cgreenbaum/Sensor-Breakout-Board/README.md

# Sensor-Breakout-Board
Sensor breakout board for routing sensor signals and CAN bussing in the Oil Pan enclosure of RW-3x.
