cgreenbaum/Sensor-Breakout-Board/AssemblyBoM.xlsx

Sensor Breakout Board V1.0
Qty | Description | Category | Manufacturer | Mfg part | Vendor | Vendor part | Unit cost | Designator
1 | CONNECTOR, RECEPTACLE HOUSING, 2 POSITION, 3MM (http://www.newark.com/molex/43025-0200/connector-receptacle-housing-2/dp/56H9399) | Connector | MOLEX | 43025-0200 | Newark | 56H9399 | $0.41 | Mating Connector for X16
5 | CONNECTOR, RECEPTACLE HOUSING, 6 POSITION, 3MM (http://www.newark.com/molex/43025-0600/connector-receptacle-housing-6/dp/01E8841) | Connector | MOLEX | 43025-0600 | Newark | 01E8841 | $0.46 | Mating Connector for X17, X18, X19, X20, X21
32 | Contact, Micro-Fit 3.0™, 43030 Series, Socket, 24 AWG, 20 AWG, Crimp, Phosphor Bronze (http://www.newark.com/molex/43030-0008/contact-socket-24-20awg-crimp/dp/56H9413) | Contacts | MOLEX | 43030-0008 | Newark | 56H9413 | $0.22
 | Subtotal |  |  |  |  |  | $9.75
