cgreenbaum/Sensor-Breakout-Board/BoM.xlsx

Sensor Breakout Board V1.0
Qty | Description | Category | Manufacturer | Mfg part | Vendor | Vendor part | Unit cost | Designator
35 | Non Populated Resistors
14 | Surface Mount Chip Resistor, Thick Film, AEC-Q200 ERJ Series, 0 ohm, 100 mW, 75 V, 0603 [1608 Metric] (http://www.newark.com/panasonic-electronic-components/erj-3gey0r00v/res-thick-film-0r-0-1w-0603/dp/65T8702) | Common passives | PANASONIC ELECTRONIC COMPONENTS (http://www.newark.com/panasonic-electronic-components) | ERJ-3GEY0R00V | Newark | 65T8702 | $0.10 | R1, R9, R12, R13, R2, R4, R6, R25, R27, R45, R47, R49, R61, R73
5 | Surface Mount Chip Resistor, Thick Film, AEC-Q200 CRCW Series, 10 kohm, 100 mW, ± 5%, 75 V (http://www.newark.com/vishay-dale/crcw060310k0jnea/res-thick-film-10k-5-0-1w-0603/dp/52K8066) | Common passives | VISHAY (http://www.newark.com/vishay) | CRCW060310K0JNEA | Newark | 52K8066 | $0.03 | R15, R28, R31, R35, R74
4 | Surface Mount Chip Resistor, Thick Film, RC Series, 1 kohm, 100 mW, ± 5%, 50 V, 0603 [1608 Metric] (http://www.newark.com/yageo/rc0603jr-131kl/res-thick-film-1k-5-0-1w-0603/dp/68R0220) | Common passives | YAGEO (http://www.newark.com/yageo) | RC0603JR-131KL | Newark | 68R0220 | $0.002 | R3, R5, R24, R26
4 | Surface Mount Chip Resistor, Thick Film, RC Series, 12 kohm, 100 mW, ± 5%, 50 V, 0603 [1608 Metric] (http://www.newark.com/yageo/rc0603jr-0712kl/res-thick-film-12k-5-0-1w-0603/dp/68R0149) | Common passives | YAGEO (http://www.newark.com/yageo) | RC0603JR-0712KL | Newark | 68R0149 | $0.001 | R16, R18, R41, R43
4 | Surface Mount Chip Resistor, Thick Film, AEC-Q200 CRCW Series, 20 kohm, 100 mW, ± 1%, 75 V (http://www.newark.com/vishay-dale/crcw060320k0fkeb/res-thick-film-20k-1-0-1w-0603/dp/43C4227) | Common passives | VISHAY (http://www.newark.com/vishay-dale/crcw060320k0fkeb/res-thick-film-20k-1-0-1w-0603/dp/43C4227) | CRCW060320K0FKEB (http://www.newark.com/vishay-dale/crcw060320k0fkeb/res-thick-film-20k-1-0-1w-0603/dp/43C4227) | Newark | 43C4227 (http://www.newark.com/vishay-dale/crcw060320k0fkeb/res-thick-film-20k-1-0-1w-0603/dp/43C4227) | $0.004 | R17, R19, R42, R44
12 | Non Populated Capacitors
16 | SMD Multilayer Ceramic Capacitor, MC Series, 270 pF, ± 10%, X7R, 50 V, 0603 [1608 Metric] (http://www.newark.com/multicomp/mc0603b271k500ct/ceramic-capacitor-270pf-50v-x7r/dp/06R4977) | Common passives | MULTICOMP (http://www.newark.com/multicomp/mc0603b271k500ct/ceramic-capacitor-270pf-50v-x7r/dp/06R4977) | MC0603B271K500CT (http://www.newark.com/multicomp/mc0603b271k500ct/ceramic-capacitor-270pf-50v-x7r/dp/06R4977) | Newark | 06R4977 (http://www.newark.com/multicomp/mc0603b271k500ct/ceramic-capacitor-270pf-50v-x7r/dp/06R4977) | $0.002 | C1, C2, C3, C5, C6, C17, C18, C21, C22, C23, C24, C25, C31, C32, C37
6 | SMD Multilayer Ceramic Capacitor, MC Series, 2.2 µF, +80%, -20%, Y5V, 10 V, 0603 [1608 Metric] (http://www.newark.com/multicomp/mc0603f225z100ct/ceramic-capacitor-2-2uf-10v-y5v/dp/06R5087) | Common passives | MULTICOMP (http://www.newark.com/multicomp/mc0603f225z100ct/ceramic-capacitor-2-2uf-10v-y5v/dp/06R5087) | MC0603F225Z100CT (http://www.newark.com/multicomp/mc0603f225z100ct/ceramic-capacitor-2-2uf-10v-y5v/dp/06R5087) | Newark | 06R5087 (http://www.newark.com/multicomp/mc0603f225z100ct/ceramic-capacitor-2-2uf-10v-y5v/dp/06R5087) | $0.01 | C4, C9, C10, C11, C12, C15
10 | Board-To-Board Connector, M22 Series, Through Hole, Receptacle, 10, 2 mm, Gold Plated Contacts (http://www.newark.com/harwin/m22-7131042/board-board-connector-receptacle/dp/71K8284?ost=M22-7131042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) | Connector | HARWIN | M22-7131042 | Newark | 71K8284 | $1.35 | X2, X3, X5, X6, X8, X9, X11, X12, X14, X15
5 | Board-To-Board Connector, M22 Series, Through Hole, Receptacle, 6, 2 mm, Gold Plated Contacts (http://www.newark.com/harwin/m22-7140342/board-board-connector-receptacle/dp/71K8300?ost=M22-7140342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) | Connector | HARWIN | M22-7140342 | Newark | 71K8300 | $0.73 | X1, X4, X7, X10, X13
1 | Contact, Micro-Fit 3.0™, 43045 Series, Through Hole, Brass (http://www.newark.com/molex/43045-0200/plug-socket-connector-header-2/dp/38C9818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) | Connector | MOLEX | 43045-0200 | Newark | 38C9818 | $0.81 | X16
5 | Header Connector,PCB Mount,RECEPT,6 Contacts,PIN,0.118 Pitch,R ANGLE PC TAIL Terminal,POLARIZED LCK (http://www.newark.com/molex/43045-0601/header-connector-pcb-mount-recept/dp/92M1173?ost=43045-0601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) | Connector | MOLEX | 43045-0601 | Newark | 92M1173 | $1.83 | X17, X18, X19, X20, X21
1 | Board-To-Board Connector, M22 Series, Through Hole, Header, 6, 2 mm, Gold Plated Contacts (http://www.newark.com/harwin/m22-2520305/board-board-connector-header-6/dp/89H8939?ost=M22-2520305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) | Connector | HARWIN | M22-2520305 | Newark | 89H8939 | $0.43 | X22
2 | Jumper (Busbar), Shunt, Shunt, Pin Headers, 2, 2 mm (http://www.newark.com/harwin/m22-1920046/jumper-socket-2way-2mm/dp/03M3588) | Jumper | HARWIN | M22-1920046 | Newark | 03M3588 | $0.15 | Mates with X22
 | Subtotal |  |  |  |  |  | $29.53
