cgreenbaum/Sensor-Breakout-Board/Modular-Sensor-Breakout-Board schematic.pdf

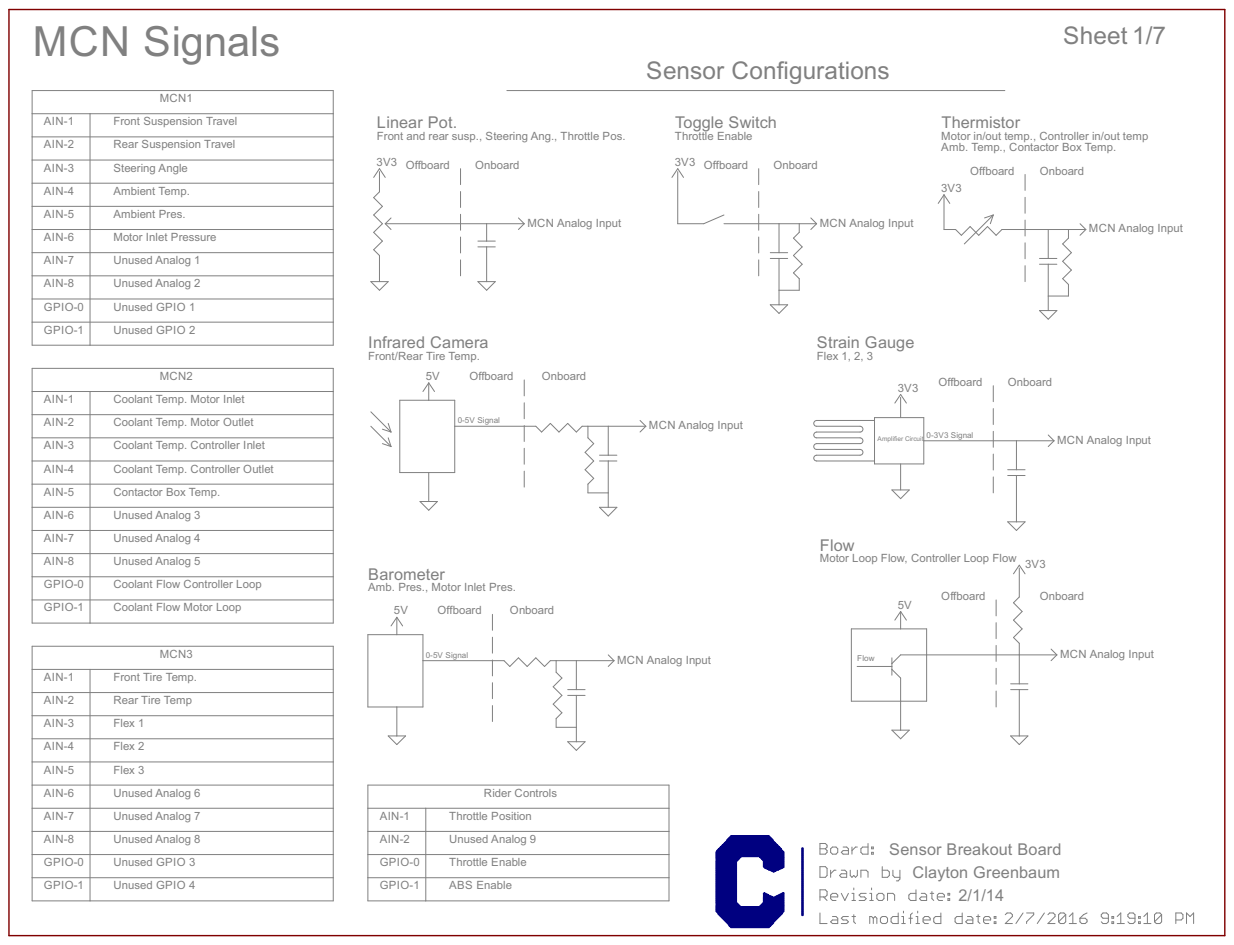
[picture p1: page 1]

AIN-1 | Front Suspension Travel

Thermistor
Motor in/out temp., Controller in/out temp
Amb. Temp., Contactor Box Temp.

AIN-2 | Rear Suspension Travel

AIN-4 | Steering Angle Ambient Temp. Ambient Pres. Motor Inlet Pressure Unused Analog 1
AIN-3

AIN-5

AIN-6

AIN-7

AIN-8 | Unused Analog 2

GPIO-0 | Unused GPIO 1

GPIO-1 | Unused GPIO 2

MCN Analog Input Amplifier Circuit 3V3

AIN-1 | Coolant Temp. Motor Inlet

AIN-2 | Coolant Temp. Motor Outlet

AIN-3 | Coolant Temp. Controller Inlet

AIN-4 | Coolant Temp. Controller Outlet

AIN-5 | Contactor Box Temp. Unused Analog 3

AIN-7 | Unused Analog 4

AIN-8 | Unused Analog 5

GPIO-0 | Coolant Flow Controller Loop

GPIO-1 | Coolant Flow Motor Loop

AIN-1 | Front Tire Temp. AIN-2

Rear Tire Temp

AIN-3 | Flex 1

AIN-4 | Flex 2

AIN-5 | Flex 3

AIN-6 | Unused Analog 6

AIN-7 | Unused Analog 7

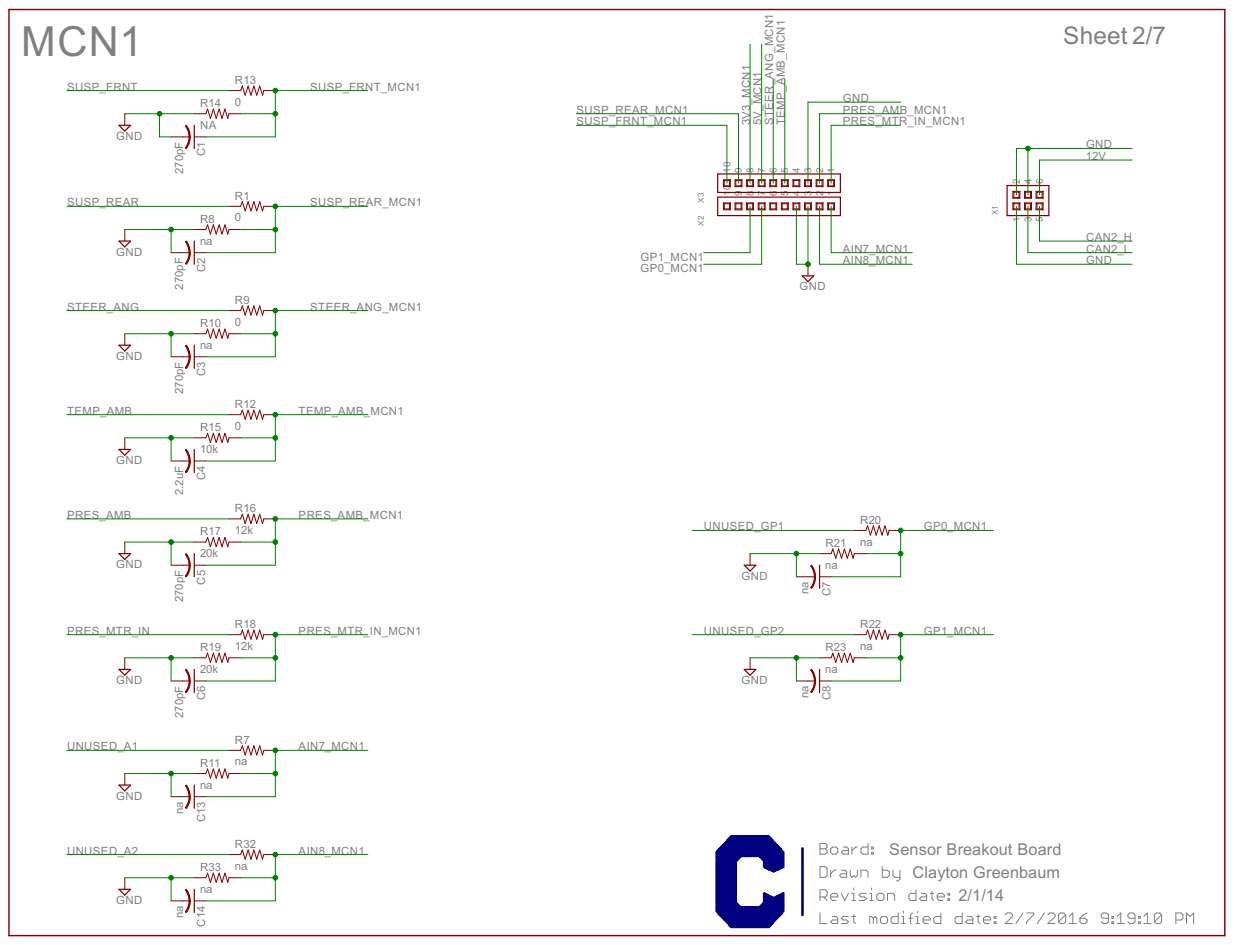
[picture p2: page 2]

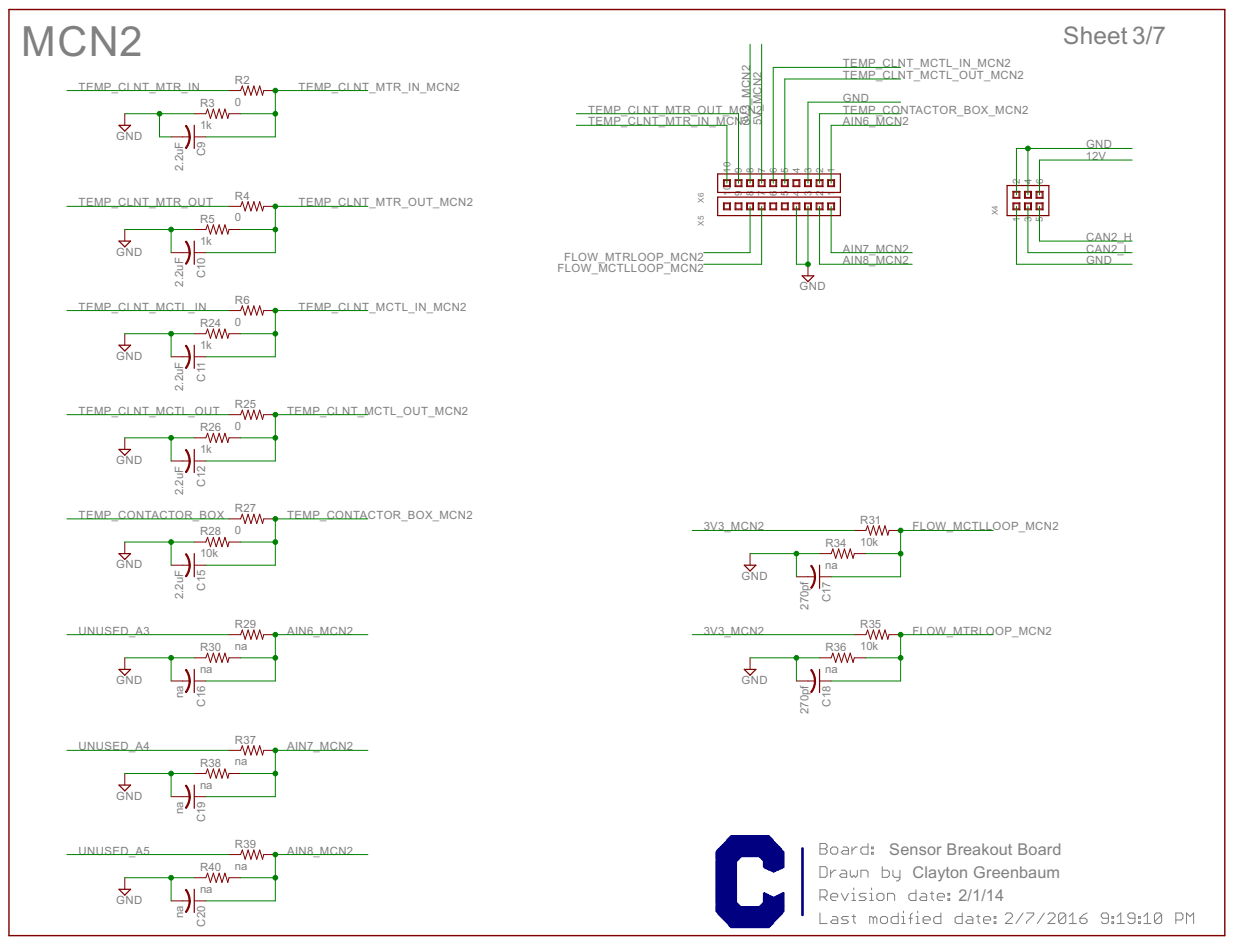
[picture p3: page 3]

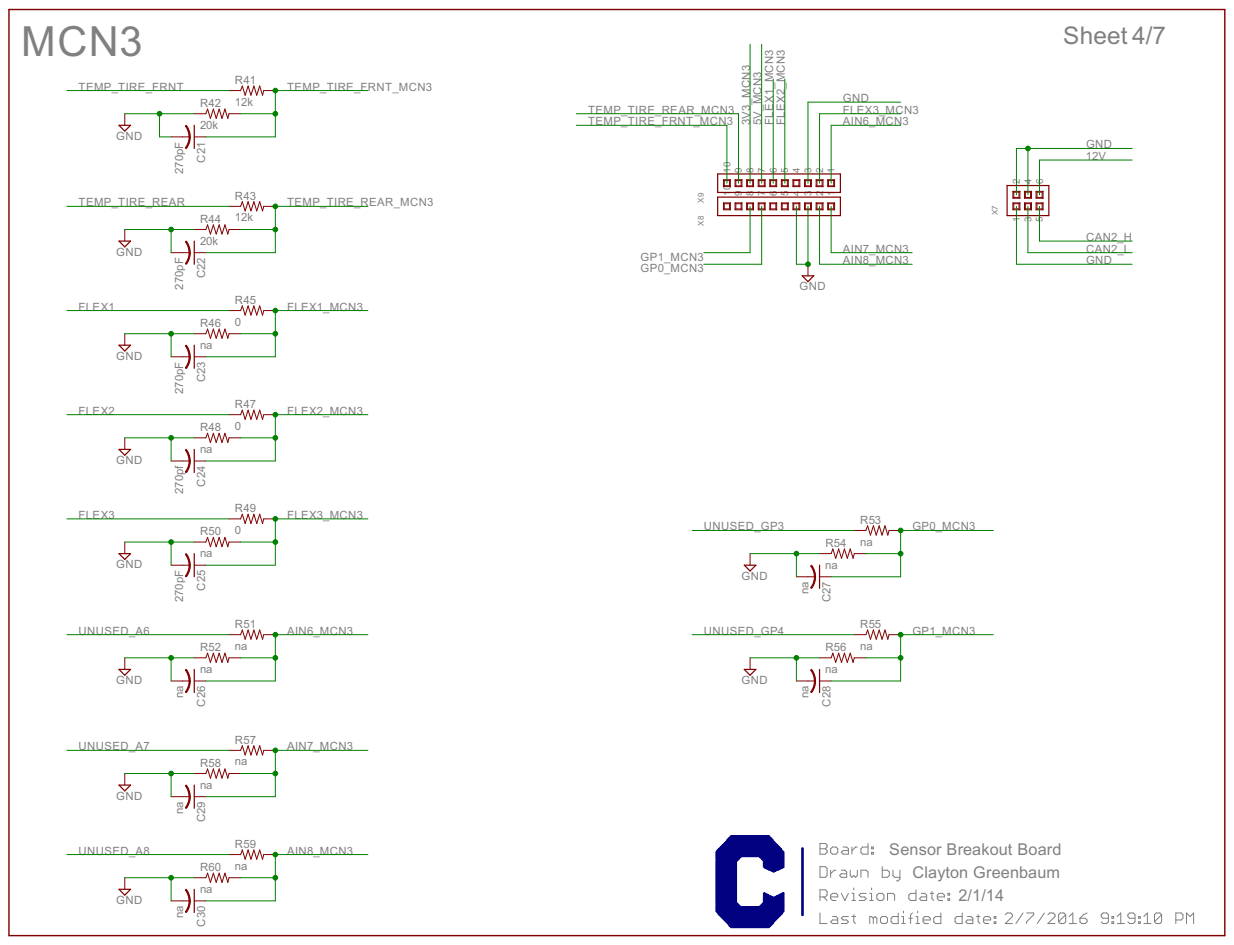
[picture p4: page 4]

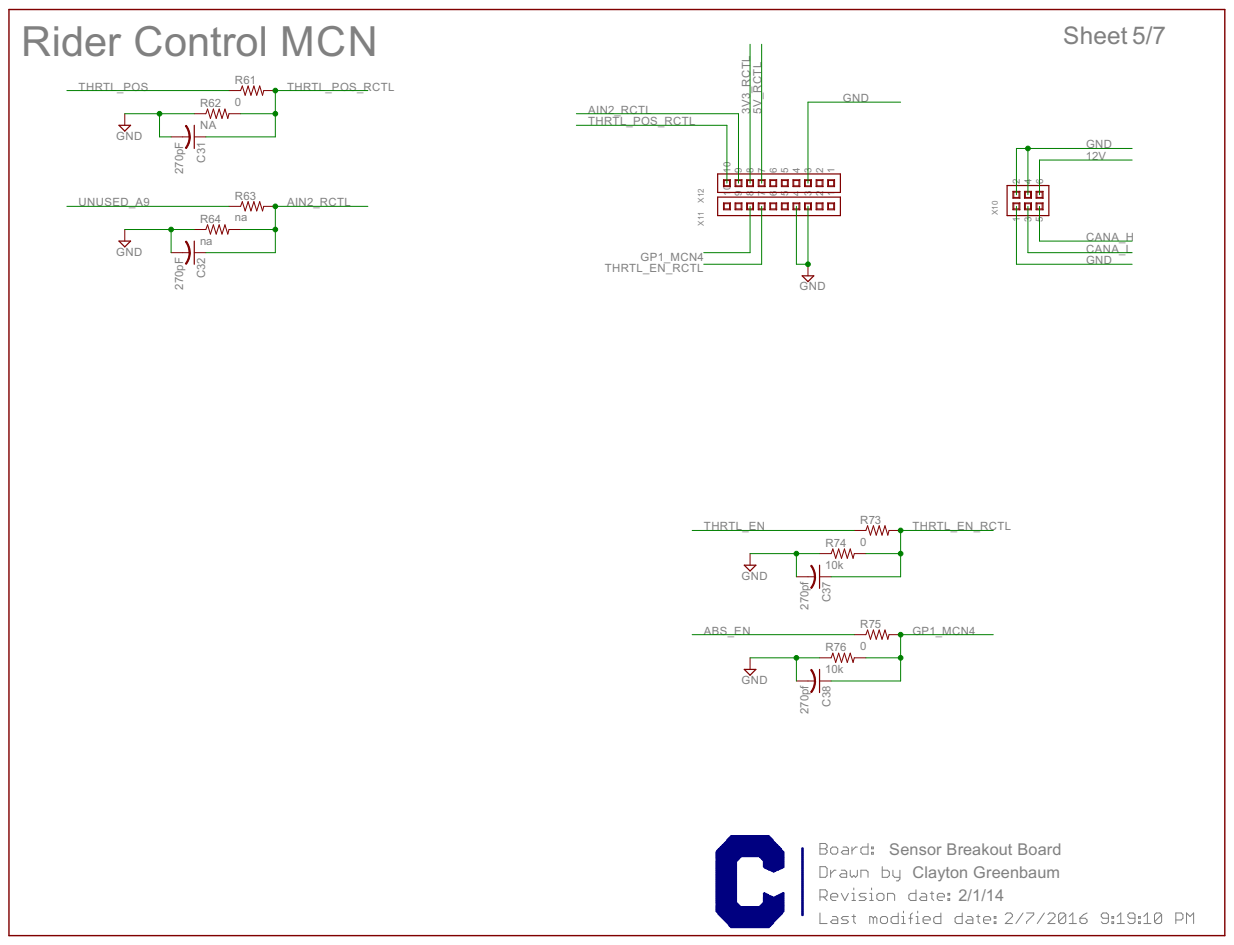
[picture p5: page 5]

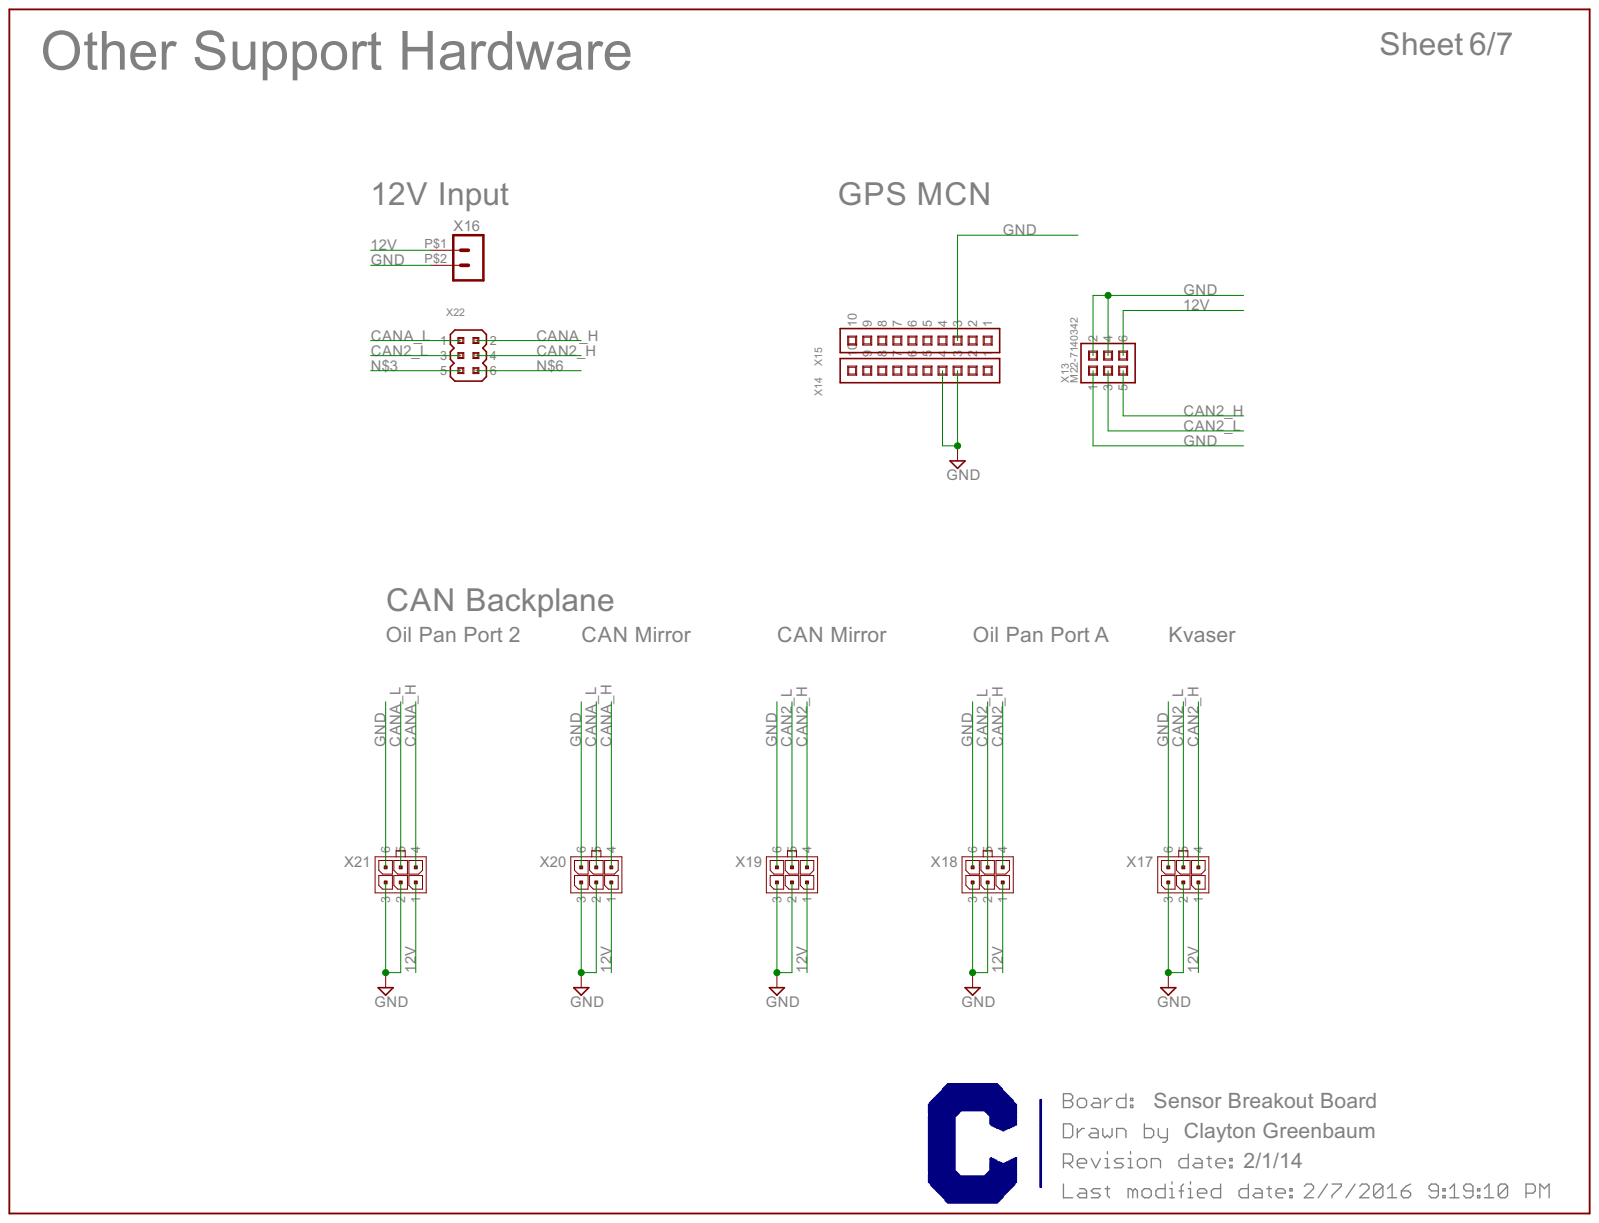
[picture p6: page 6]

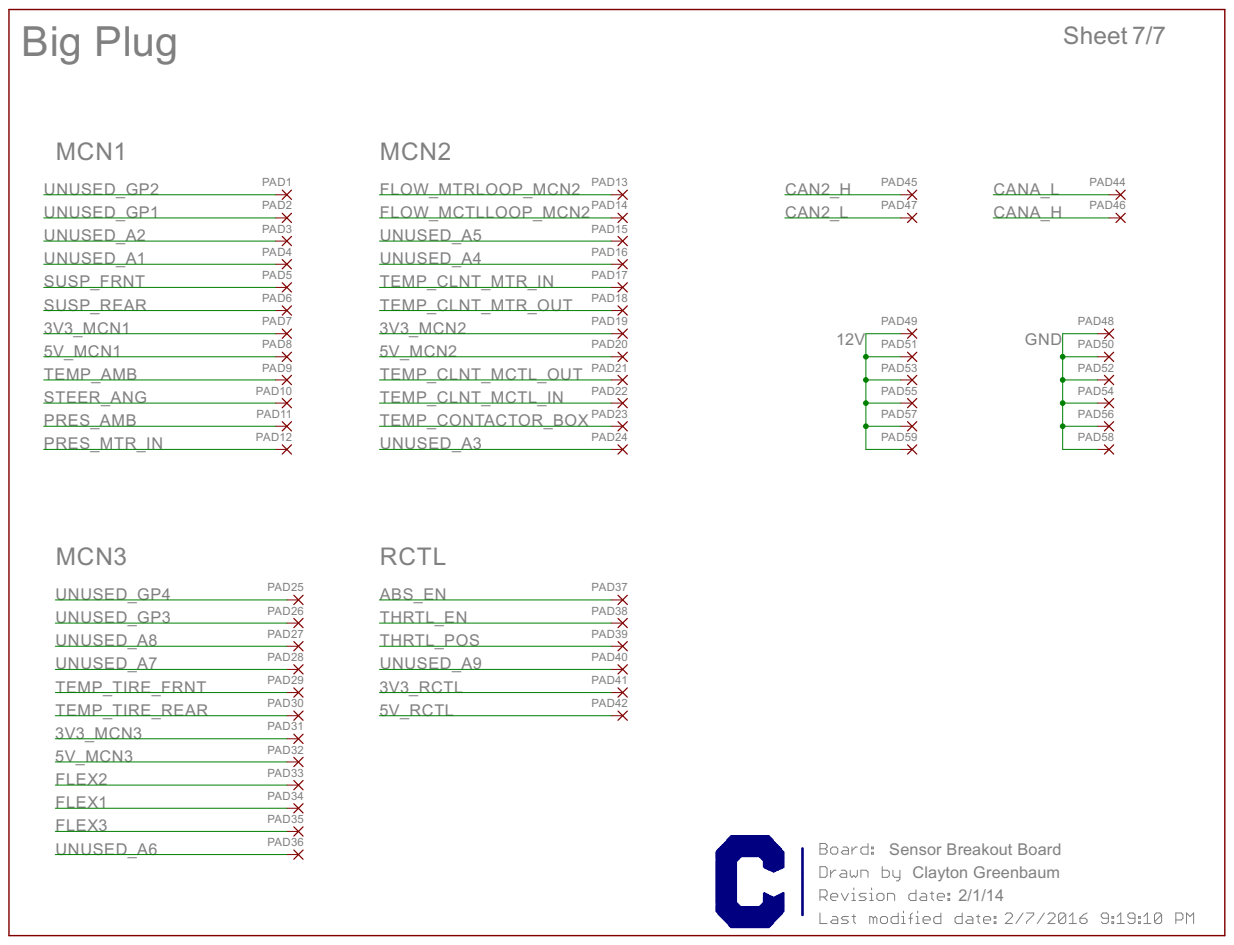
[picture p7: page 7]
