cgreenbaum/Sensor-Breakout-Board/Modular-Sensor-Breakout-Board - bottom.pdf

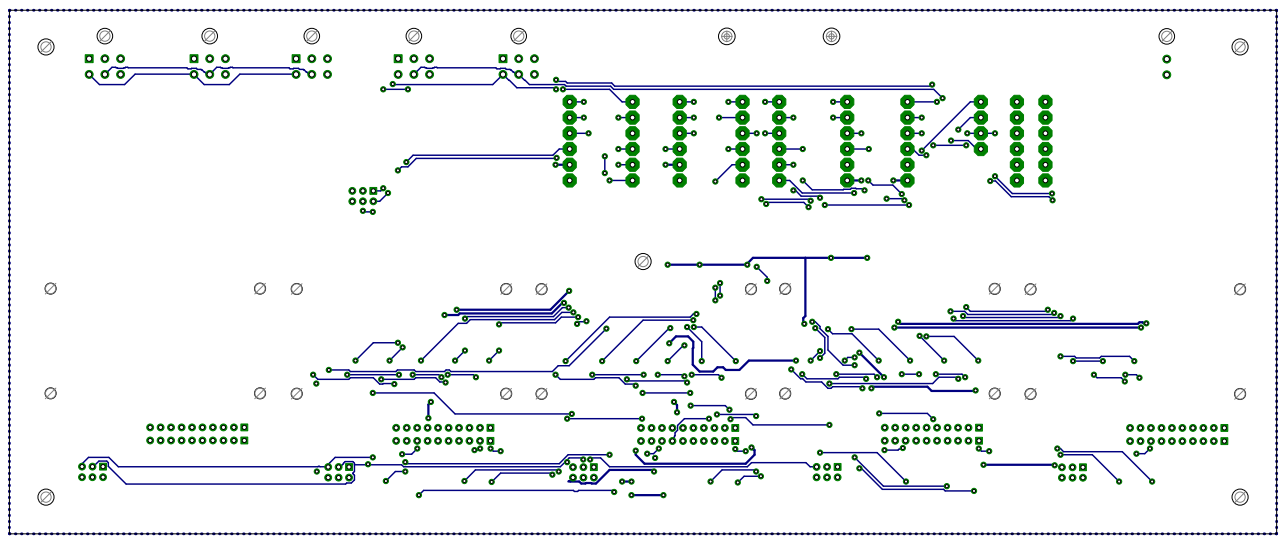
[picture p8: page 1]
