cgreenbaum/Sensor-Breakout-Board/Modular-Sensor-Breakout-Board - top.pdf

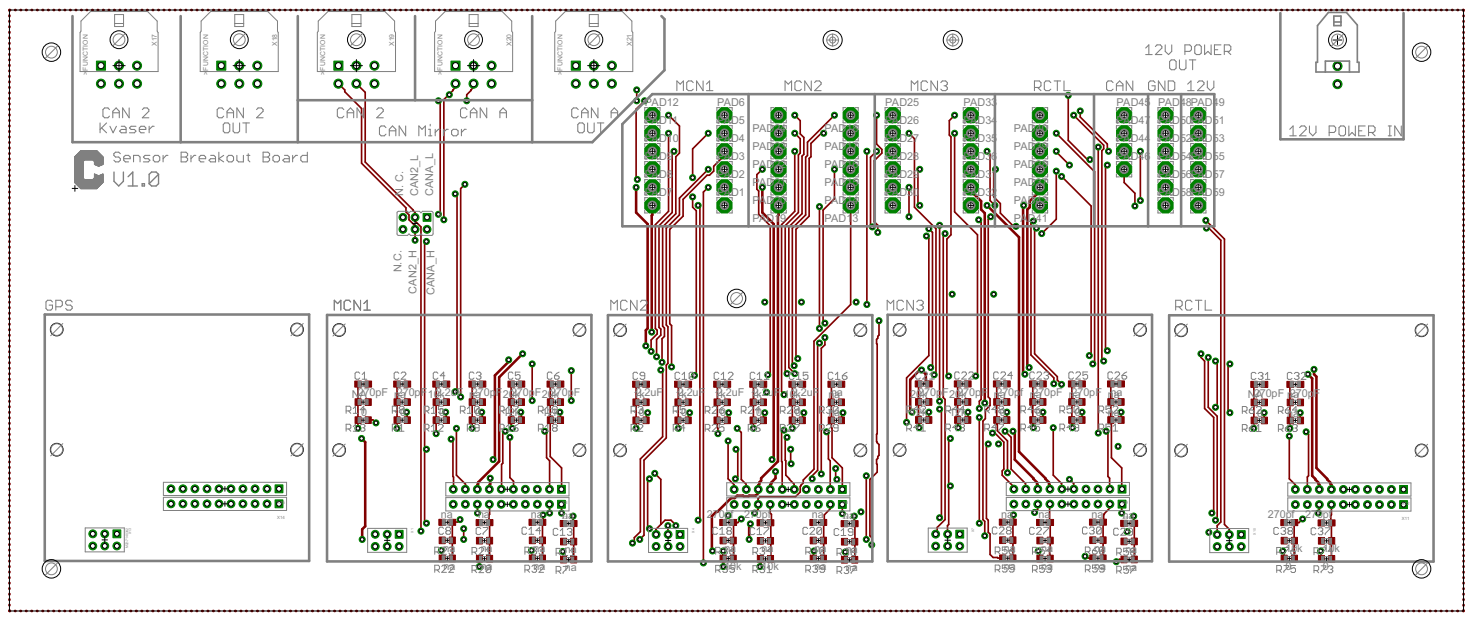
[picture p9: page 1]
