cgreenbaum/Sensor-Breakout-Board/(commit log)

2016-01-31 Board First Revision completed. Clearance issues
    [Modular-Sensor-Breakout-Board.brd, Modular-Sensor-Breakout-Board.sch, Modular-Sensor-Breakout-Board2.brd, Modular-Sensor-Breakout-Board2.sch, Sensor-Breakout-Board.brd, Sensor-Breakout-Board.sch, Sensor-Breakout-Module.brd, Sensor-Breakout-Module.sch]
2016-02-01 Almost done.
    [Modular-Sensor-Breakout-Board4.brd, Modular-Sensor-Breakout-Board4.sch]
2016-02-01 Fixed remaining airwires.
    [Modular-Sensor-Breakout-Board4.brd]
2016-02-01 Removed garbage files.
    [Modular-Sensor-Breakout-Board.brd, Modular-Sensor-Breakout-Board.sch, Modular-Sensor-Breakout-Board2.brd, Modular-Sensor-Breakout-Board2.sch, Modular-Sensor-Breakout-Board3.brd, Modular-Sensor-Breakout-Board3.sch, Modular-Sensor-Breakout-Board4.brd, Modular-Sensor-Breakout-Board4.sch]
2016-02-01 Add schematic, board top, board bottom PDFs
2016-02-01 Added CAM files
    [Board Outline.GKO, Bottom Layer.GBL, Bottom Silk Screen.GBO, Bottom Solder Mask.GBS, Drills.XLN, Top Layer.GTL, Top Silk Screen.GTO, Top Solder Mask.GTS]
2016-02-01 * Increased drill size on a couple vias that were less than 24mil. * Added info to the silkscreen for ECAD standards
    [Modular-Sensor-Breakout-Board.brd]
2016-02-01 Added date to title block
    [Modular-Sensor-Breakout-Board.sch]
2016-02-07 Added 2 more screw holes
    [Modular-Sensor-Breakout-Board.brd]
2016-02-07 Added signal/sensor documentation, updated component values
    [Modular-Sensor-Breakout-Board.sch]
2016-02-07 Updated CAM
    [Board Outline.GKO, Bottom Layer.GBL, Bottom Solder Mask.GBS, Drills.XLN]
2016-02-07 Updated CAM files
    [Top Layer.GTL, Top Silk Screen.GTO, Top Solder Mask.GTS]
2016-02-07 Created BOM
    [BoM.xlsx]
2016-02-07 Listed needed updates
    [BoM.xlsx]
2016-02-08 Moved some BoM components to Assembly BoM
    [BoM.xlsx]
2016-02-08 Created an assembly BoM with components needed for the final assembly but not residing on the board.
    [AssemblyBoM.xlsx]
2016-02-08 Updated silk screen, changed dimensions of board, added a jumper to short CAN busses together, increased size of screw holes
    [Modular-Sensor-Breakout-Board.brd]
2016-02-08 Added a jumper to short CAN busses together.
    [Modular-Sensor-Breakout-Board.sch]
2016-02-08 Changed jumper; added ABS_EN signal to RCTL
    [Modular-Sensor-Breakout-Board.brd, Modular-Sensor-Breakout-Board.sch]
2016-02-08 Added 270pf filter cap on ABS_EN input
    [Modular-Sensor-Breakout-Board.brd, Modular-Sensor-Breakout-Board.sch]
2016-02-08 Updated BoM to reflect added capacitor.
    [AssemblyBoM.xlsx, BoM.xlsx]
2016-02-08 Updated board pdfs
2016-02-08 Updated CAM files.
    [Board Outline.GKO, Bottom Layer.GBL, Bottom Solder Mask.GBS, Drills.XLN, Top Layer.GTL, Top Silk Screen.GTO, Top Solder Mask.GTS]
2016-02-08 Renamed project files
    [Sensor-Breakout-Board.brd, Sensor-Breakout-Board.sch]
2016-02-08 Deleted unused files.
    [Sensor-Breakout-Module.brd, Sensor-Breakout-Module.sch]
2016-02-08 Cleaned up some unused cells in the BoM. Closes #1.
    [AssemblyBoM.xlsx, BoM.xlsx]
